sanderfu/ttk4155-PCB/BOM.xlsx

Component | Amount | Designators | DigiKey Ref | I handleliste
22pF 0805 Capacitor | 4 | C1, C2, C7, C8 | 399-1113-1-ND‎ | j
0.1 uF 0805 Capacitor | 10 | C3, C5, C6, C9, C10, C11, C12, C13, C14, C15 | 1276-1007-1-ND | j
0.22uF 0805 Capacitor | 1 | C4 | 1276-6478-1-ND | j
PWR_LED 0805 | 3 | D1 | 732-4982-1-ND | j
Power_rail header 8 pin (2x4) | 1 | J1 | 732-5296-ND | j
JTAG LINK header 8 pin (2x4) | 1 | J2 | 732-5296-ND | j
OLED_Connection header 12 pin | 1 | J3 | 732-5323-ND | j
CAN header 2 pin | 1 | J4 | 732-5315-ND | j
P1000 header 9 pin | 1 | J5 | 732-5322-ND | j
DB9 Connector (UART) | 1 | J6 | AE10921-ND | j
10k 0805 Resistor | 1 | R1 | RNCP0805FTD10K0CT-ND‎ | j
330 0805 resistor | 1 | R2 | A106061CT-ND‎ | j
150 0805 resistor | 1 | R3 | RNCP0805FTD150RCT-ND | j
22k 0805 resistor | 1 | R4 | RR12P22.0KDCT-ND‎ | j
120 0805 resistor | 1 | R5 | A129738CT-ND | j
Pushbutton | 2 | S1 | GPTS203211B | j
Barrel jack | 2 | U1 | CP-002A-ND | j
LM340SX | 2 | U2 | LM340SX-5.0/NOPBCT-ND | j
DIP-40_W15.24 (For MCU) | 1 | U3 | ‎ED3048-5-ND‎ | j
DIP-20_W7.62 (For GAL) | 1 | U4 | ‎ED3054-5-ND‎ | j
DIP-18_W7.62(for MCP2515) | 1 | U5 | ED3047-5-ND‎ | j
DIP-20_W7.62 (for SN74ALS…) | 1 | U6 | ‎ED3054-5-ND‎ | j
DIP-8_W7.62 (for mcp 2551) | 1 | U7 | AE9986-ND‎ | j
DIP-28_W7.62 (for IDT7164) | 1 | U8 | ED3050-5-ND‎ | j
DIP-20_W7.62 (for ADC0844) | 1 | U9 | ‎ED3054-5-ND‎ | j
DIP-20_W7.62 (for MAX233) | 1 | U10 | ‎ED3054-5-ND‎ | j
Crystal SMD_HC49-SD 4.9152 Hz | 2 | Y1 | 631-1007-1-ND | j
Crystal SMD_HC49-SD 16 MHz | 2 | Y2 | 631-1017-1-ND | j
Cable to OLED | 2 |  | 1568-1938-ND | j
Cable to P1000 | 1 |  | 1568-1513-ND | j
