sanderfu/ttk4155-PCB/pictures/schematic.pdf

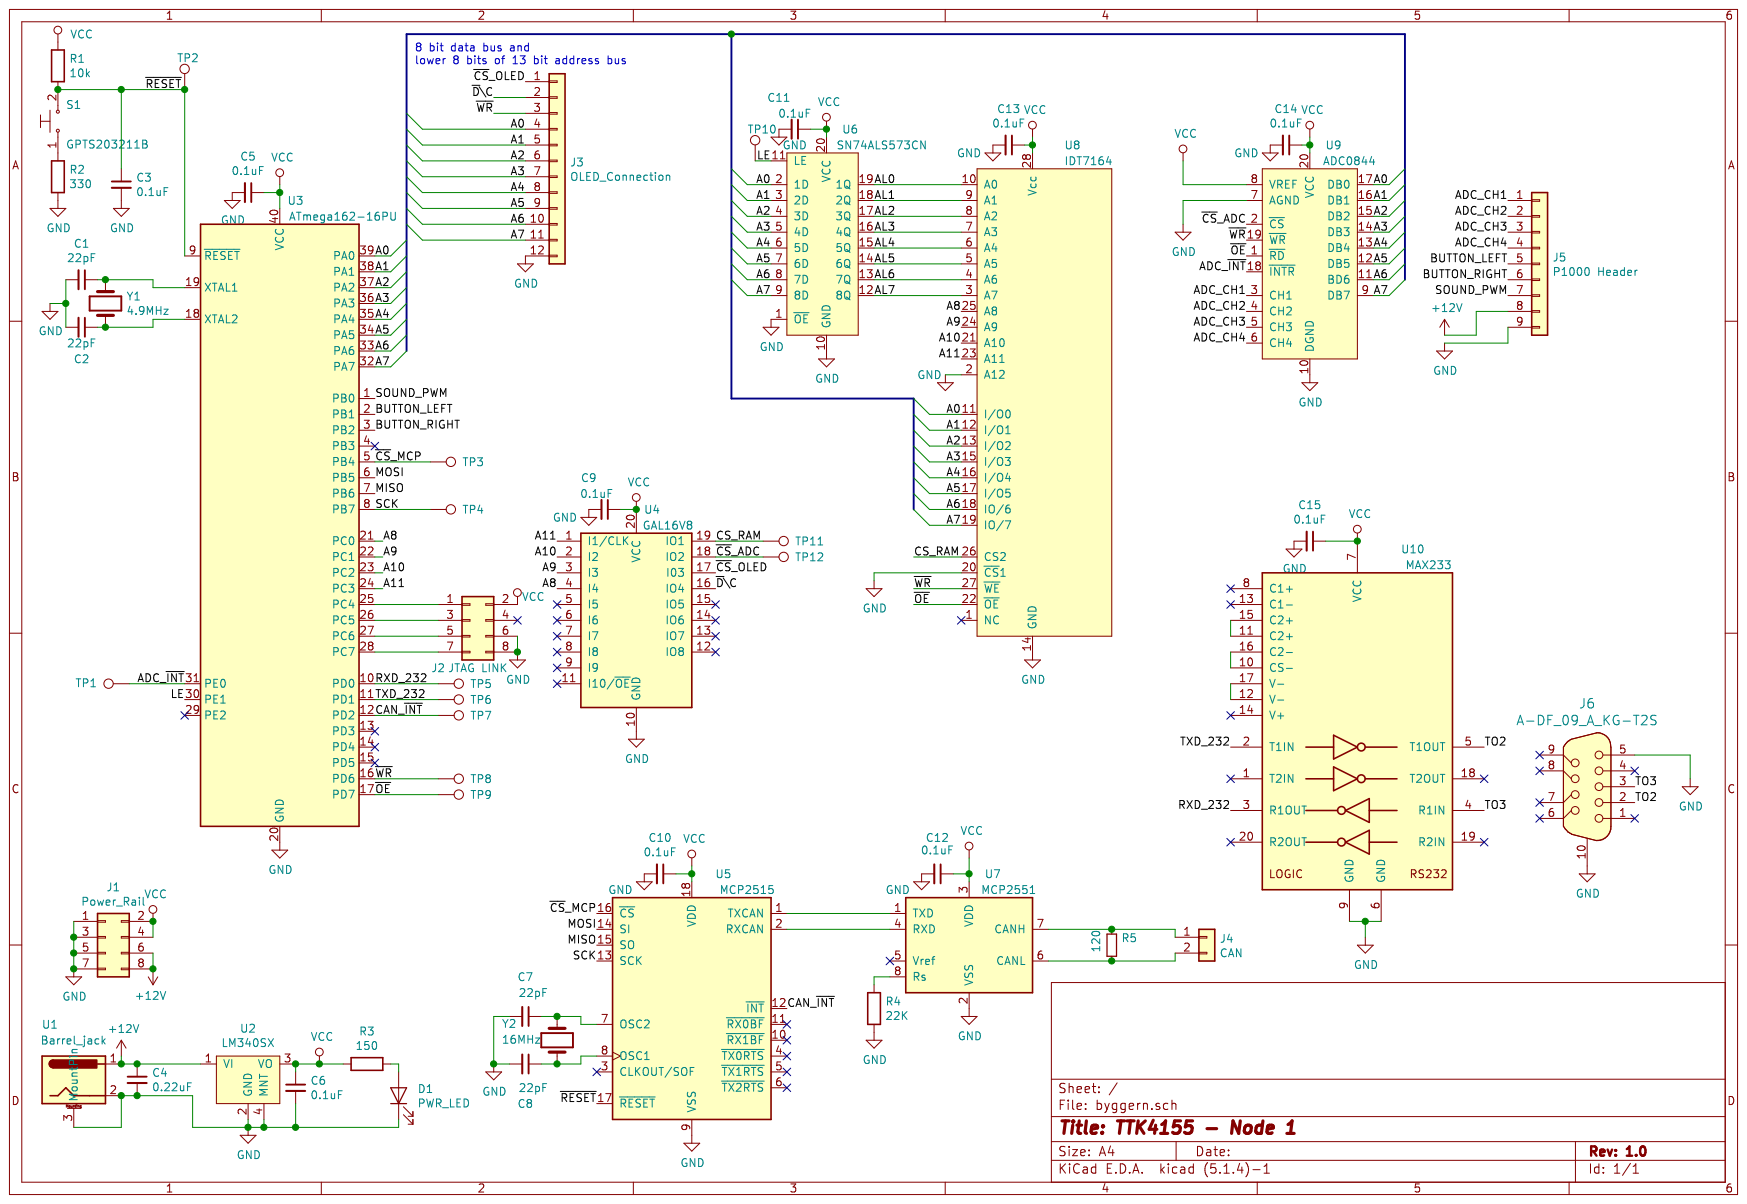
[picture p1: page 1]
