sanderfu/ttk4155-PCB/byggern.kicad_pcb

## KiCad design byggern.kicad_pcb (2019-10-15)

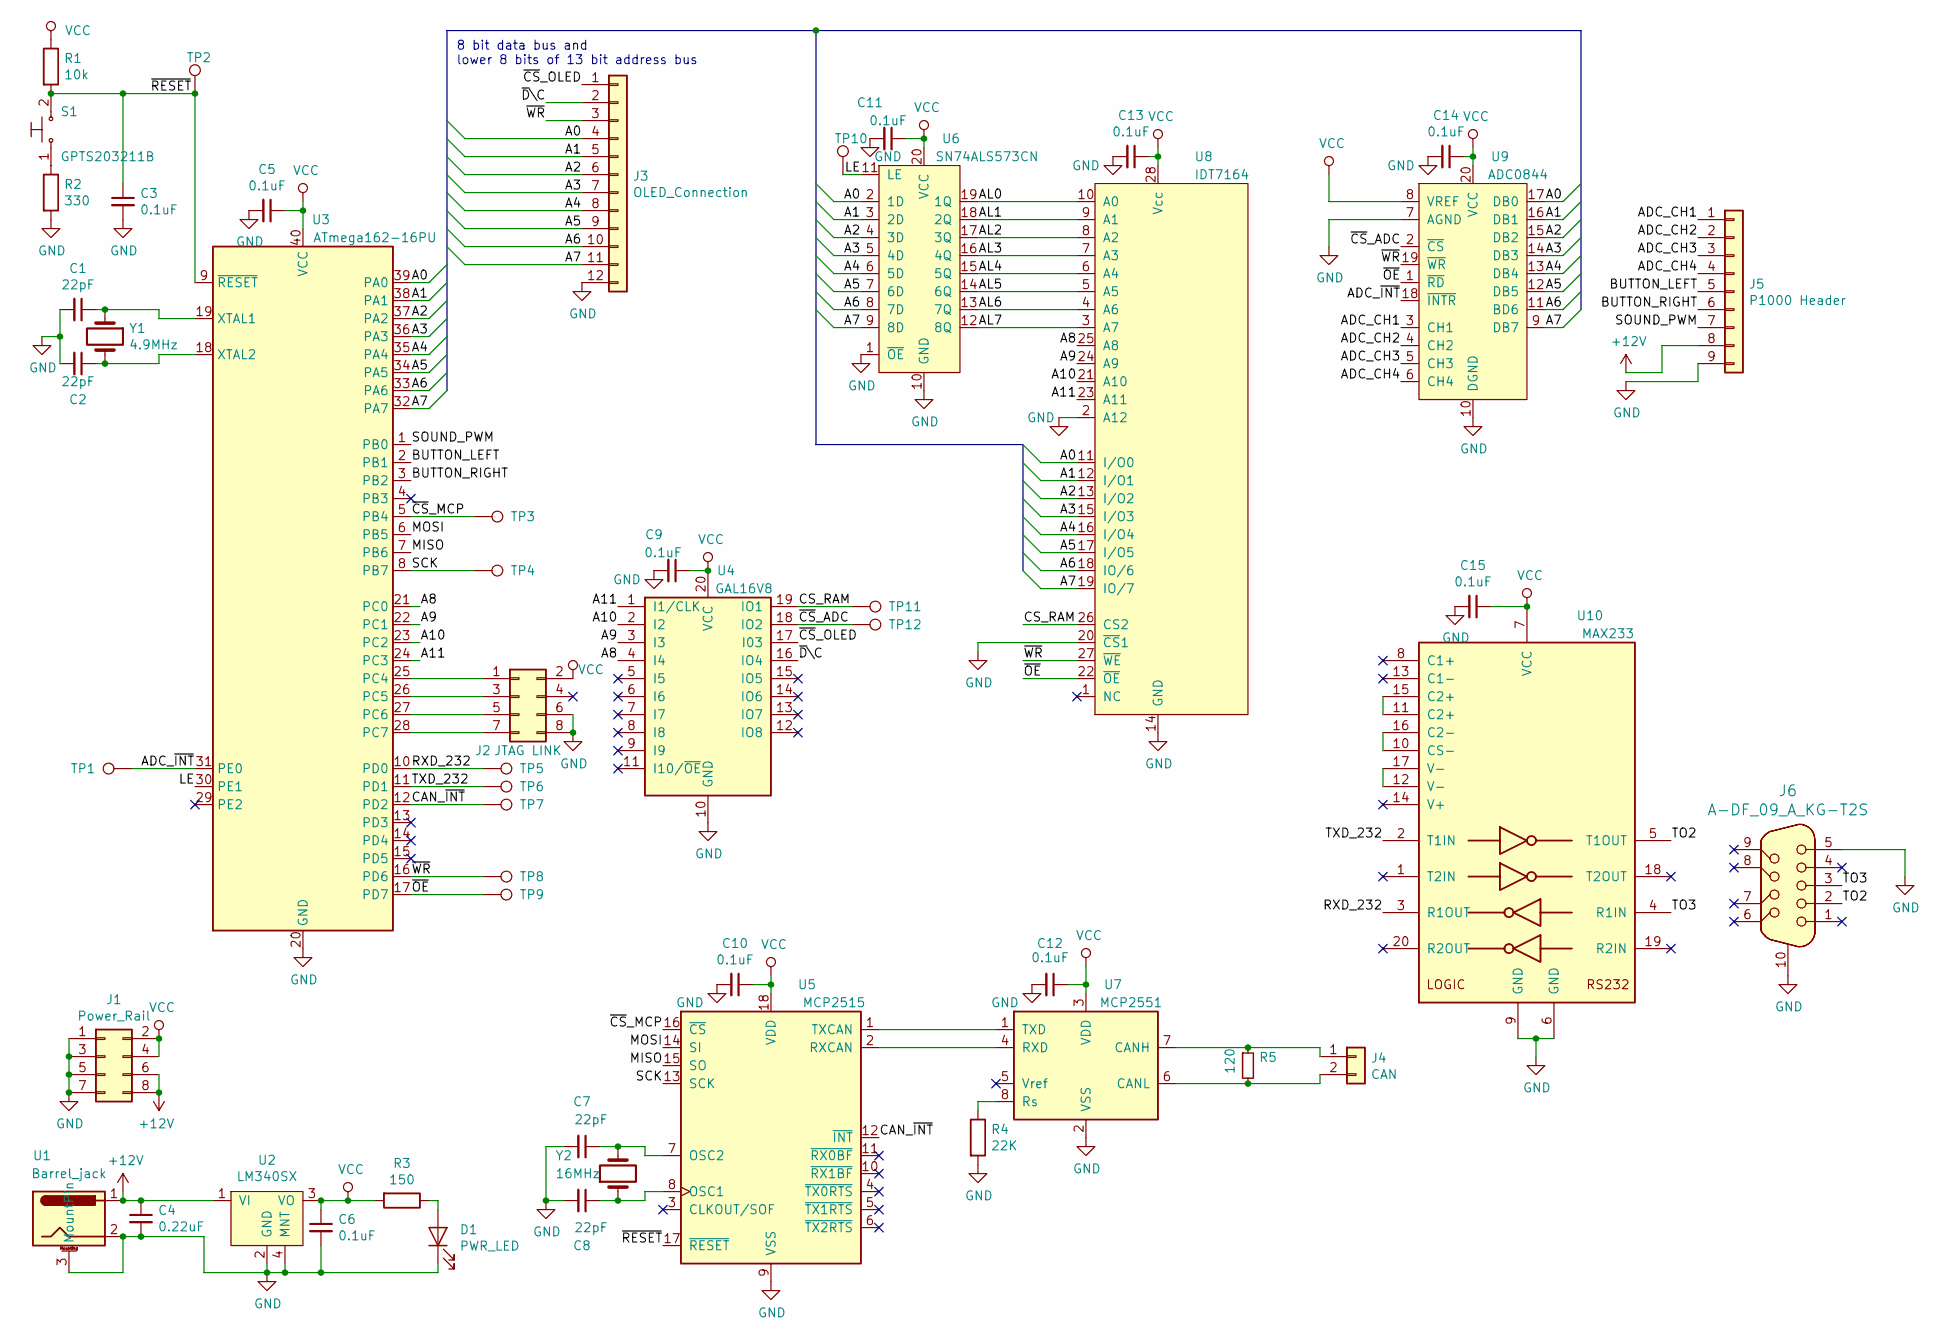
[picture p2: schematic byggern.sch, TTK4155 - Node 1]

Parts:
C1, C2, C7, C8: 22pF; C_0805_2012Metric_Pad1.15x1.40mm_HandSolder
C3, C5, C6, C9, C10, C11, C12, C13, C14, C15: 0.1uF; C_0805_2012Metric_Pad1.15x1.40mm_HandSolder
C4: 0.22uF; C_0805_2012Metric_Pad1.15x1.40mm_HandSolder
D1: PWR_LED; LED_0805_2012Metric_Pad1.15x1.40mm_HandSolder
J1: Power_Rail; PinHeader_2x04_P2.54mm_Vertical
J2: JTAG LINK; PinHeader_2x04_P2.54mm_Vertical
J3: OLED_Connection; PinHeader_1x12_P2.54mm_Vertical
J4: CAN; PinHeader_1x02_P2.54mm_Vertical
J5: P1000 Header; PinHeader_1x09_P2.54mm_Vertical
J6: A-DF_09_A_KG-T2S; DSUB-9_Receptical_A-DF_09_A_KG-T2S; MPN A-DF 09 A/KG-T2S; Digi-Key_PN AE10921-ND
R1: 10k; R_0805_2012Metric_Pad1.15x1.40mm_HandSolder
R2: 330; R_0805_2012Metric_Pad1.15x1.40mm_HandSolder
R3: 150; R_0805_2012Metric_Pad1.15x1.40mm_HandSolder
R4: 22K; R_0805_2012Metric_Pad1.15x1.40mm_HandSolder
R5: 120; R_0805_2012Metric_Pad1.15x1.40mm_HandSolder
S1: GPTS203211B; PushButton_12x12mm_THT_GPTS203211B; MPN GPTS203211B; Digi-Key_PN CW181-ND
TP1, TP2, TP3, TP4, TP5, TP6, TP7, TP8, TP9, TP10, TP11, TP12: TestPoint; TestPoint_Pad_D1.5mm
U1: Barrel_jack; BarrelJack_Horizontal
U2: LM340SX
U3: ATmega162-16PU; DIP-40_W15.24mm_Socket
U4: GAL16V8; DIP-20_W7.62mm_Socket
U5: MCP2515; DIP-18_W7.62mm_Socket
U6: SN74ALS573CN; DIP-20_W7.62mm_Socket
U7: MCP2551; DIP-8_W7.62mm_Socket
U8: IDT7164; DIP-28_W7.62mm_Socket
U9: ADC0844; DIP-20_W7.62mm_Socket
U10: MAX233; DIP-20_W7.62mm_Socket
Y1: 4.9MHz; Crystal_SMD_HC49-SD_HandSoldering
Y2: 16MHz; Crystal_SMD_HC49-SD_HandSoldering

Connections:
+12V: C4.1, J1.6, J1.8, J5.8, U1.1, U2.1 (VI)
/A0: J3.4, U3.39 (PA0), U6.2 (1D), U8.11 (I/O0), U9.17 (DB0)
/A1: J3.5, U3.38 (PA1), U6.3 (2D), U8.12 (I/O1), U9.16 (DB1)
/A2: J3.6, U3.37 (PA2), U6.4 (3D), U8.13 (I/O2), U9.15 (DB2)
/A3: J3.7, U3.36 (PA3), U6.5 (4D), U8.15 (I/O3), U9.14 (DB3)
/A4: J3.8, U3.35 (PA4), U6.6 (5D), U8.16 (I/O4), U9.13 (DB4)
/A5: J3.9, U3.34 (PA5), U6.7 (6D), U8.17 (I/O5), U9.12 (DB5)
/A6: J3.10, U3.33 (PA6), U6.8 (7D), U8.18 (IO/6), U9.11 (BD6)
/A7: J3.11, U3.32 (PA7), U6.9 (8D), U8.19 (IO/7), U9.9 (DB7)
/A8: U3.21 (PC0), U4.4 (I4), U8.25 (A8)
/A9: U3.22 (PC1), U4.3 (I3), U8.24 (A9)
/A10: U3.23 (PC2), U4.2 (I2), U8.21 (A10)
/A11: U3.24 (PC3), U4.1 (I1/CLK), U8.23 (A11)
/ADC_CH1: J5.1, U9.3 (CH1)
/ADC_CH2: J5.2, U9.4 (CH2)
/ADC_CH3: J5.3, U9.5 (CH3)
/ADC_CH4: J5.4, U9.6 (CH4)
/ADC_~INT~: TP1.1, U3.31 (PE0), U9.18 (~INTR)
/AL0: U6.19 (1Q), U8.10 (A0)
/AL1: U6.18 (2Q), U8.9 (A1)
/AL2: U6.17 (3Q), U8.8 (A2)
/AL3: U6.16 (4Q), U8.7 (A3)
/AL4: U6.15 (5Q), U8.6 (A4)
/AL5: U6.14 (6Q), U8.5 (A5)
/AL6: U6.13 (7Q), U8.4 (A6)
/AL7: U6.12 (8Q), U8.3 (A7)
/BUTTON_LEFT: J5.5, U3.2 (PB1)
/BUTTON_RIGHT: J5.6, U3.3 (PB2)
/CAN_~INT~: TP7.1, U3.12 (PD2), U5.12 (~INT)
/CS_RAM: TP11.1, U4.19 (IO1), U8.26 (CS2)
/LE: TP10.1, U3.30 (PE1), U6.11 (LE)
/MISO: U3.7 (PB6), U5.15 (SO)
/MOSI: U3.6 (PB5), U5.14 (SI)
/RXD_232: TP5.1, U3.10 (PD0), U10.3 (R1OUT)
/SCK: TP4.1, U3.8 (PB7), U5.13 (SCK)
/SOUND_PWM: J5.7, U3.1 (PB0)
/TO2: J6.2, U10.5 (T1OUT)
/TO3: J6.3, U10.4 (R1IN)
/TXD_232: TP6.1, U3.11 (PD1), U10.2 (T1IN)
/~CS~_ADC: TP12.1, U4.18 (IO2), U9.2 (~CS~)
/~CS~_MCP: TP3.1, U3.5 (PB4), U5.16 (~CS)
/~CS~_OLED: J3.1, U4.17 (I03)
/~D~\C: J3.2, U4.16 (IO4)
/~OE~: TP9.1, U3.17 (PD7), U8.22 (~OE), U9.1 (~RD)
/~RESET~: C3.1, R1.2, S1.2, TP2.1, U3.9 (~RESET), U5.17 (~RESET)
/~WR~: J3.3, TP8.1, U3.16 (PD6), U8.27 (~WE), U9.19 (~WR)
GND: C1.2, C2.2, C3.2, C4.2, C5.2, C6.2, C7.2, C8.2, C9.2, C10.2, C11.2, C12.2, C13.2, C14.2, C15.2, D1.1 (K), J1.1, J1.3, J1.5, J1.7, J2.6, J2.8, J3.12, J5.9, J6.5, J6.10, R2.2, R4.2, U1.2, U1.3 (MountPin), U2.2 (GND), U2.4 (MNT), U3.20 (GND), U4.10 (GND), U5.9 (VSS), U6.1 (~OE), U6.10 (GND), U7.2 (VSS), U8.2 (A12), U8.14 (GND), U8.20 (~CS~1), U9.7 (AGND), U9.10 (DGND), U10.6 (GND), U10.9 (GND)
unnamed: C1.1, U3.19 (XTAL1), Y1.1
unnamed: C2.1, U3.18 (XTAL2), Y1.2
unnamed: C7.1, U5.7 (OSC2), Y2.2
unnamed: C8.1, U5.8 (OSC1), Y2.1
unnamed: D1.2 (A), R3.1
unnamed: J2.1, U3.25 (PC4)
unnamed: J2.3, U3.26 (PC5)
unnamed: J2.5, U3.27 (PC6)
unnamed: J2.7, U3.28 (PC7)
unnamed: J4.1, R5.1, U7.7 (CANH)
unnamed: J4.2, R5.2, U7.6 (CANL)
unnamed: R2.1, S1.1
unnamed: R4.1, U7.8 (Rs)
unnamed: U5.1 (TXCAN), U7.1 (TXD)
unnamed: U5.2 (RXCAN), U7.4 (RXD)
unnamed: U10.10 (CS-), U10.16 (C2-)
unnamed: U10.11 (C2+), U10.15 (C2+)
unnamed: U10.12 (V-), U10.17 (V-)
VCC: C5.1, C6.1, C9.1, C10.1, C11.1, C12.1, C13.1, C14.1, C15.1, J1.2, J1.4, J2.2, R1.1, R3.2, U2.3 (VO), U3.40 (VCC), U4.20 (VCC), U5.18 (VDD), U6.20 (VCC), U7.3 (VDD), U8.28 (Vcc), U9.8 (VREF), U9.20 (VCC), U10.7 (VCC)

Notes on the sheet:
8 bit data bus and lower 8 bits of 13 bit address bus

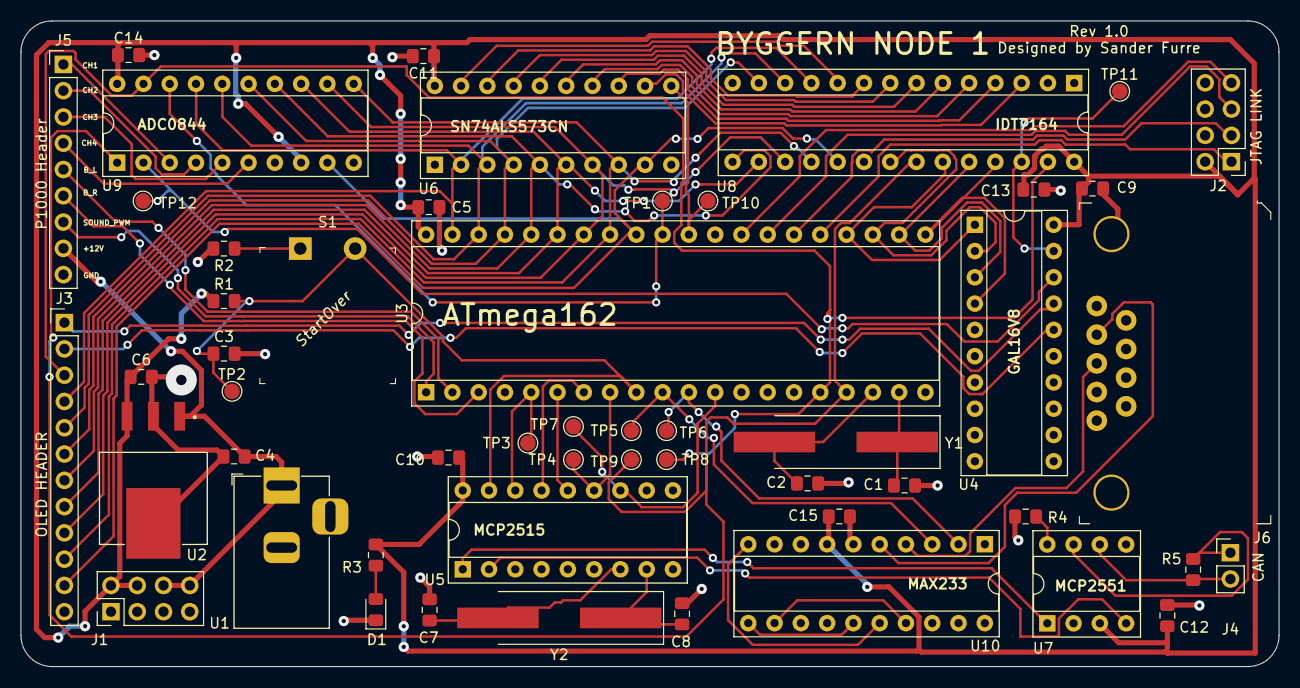
[picture p3: board byggern.kicad_pcb from above]

Board: 2 copper layers, 121.6 x 62.4 mm, 52 parts (0 on the bottom side), 66 nets.
