sanderfu/ttk4155-PCB/(commit log)

2019-10-09 Update schematic with usart interface
    [byggern.sch]
2019-10-09 Complete schematic, quality check remaining
    [byggern.sch]
2019-10-09 Correct warnings from electrical error check and change tri-state to output rule to ignore, no critical warnings left
    [byggern.sch]
2019-10-09 Correct error in gitignore and add power to P1000-header
    [byggern.sch]
2019-10-09 Change name of P1000 Header
    [byggern.sch]
2019-10-10 Start assignment of footprints
    [byggern.sch]
2019-10-11 Create footprint library with ICs specific to the project
2019-10-11 Add footprints to components
    [byggern.sch]
2019-10-11 Start routing PCB
    [byggern.kicad_pcb, byggern.sch]
2019-10-12 Change footprints of ICs to DIPs and Close to finish routing
    [byggern.kicad_pcb, byggern.sch]
2019-10-15 Add BOM (Last commit was unsuccesful at it)
    [BOM.xlsx]
2019-10-15 Add fabrication files
    [byggern-B_Cu.gbr, byggern-B_Mask.gbr, byggern-B_SilkS.gbr, byggern-Edge_Cuts.gbr, byggern-F_Cu.gbr, byggern-F_Mask.gbr, byggern-F_Paste.gbr, byggern-F_SilkS.gbr]
2019-10-15 Fix errors and update BOM
    [BOM.xlsx, byggern.kicad_pcb, byggern.sch]
2019-10-23 Add schematic and PCB render
